Tanex2907/Semester-3-Project/Morphology Chart/List of features V1.png

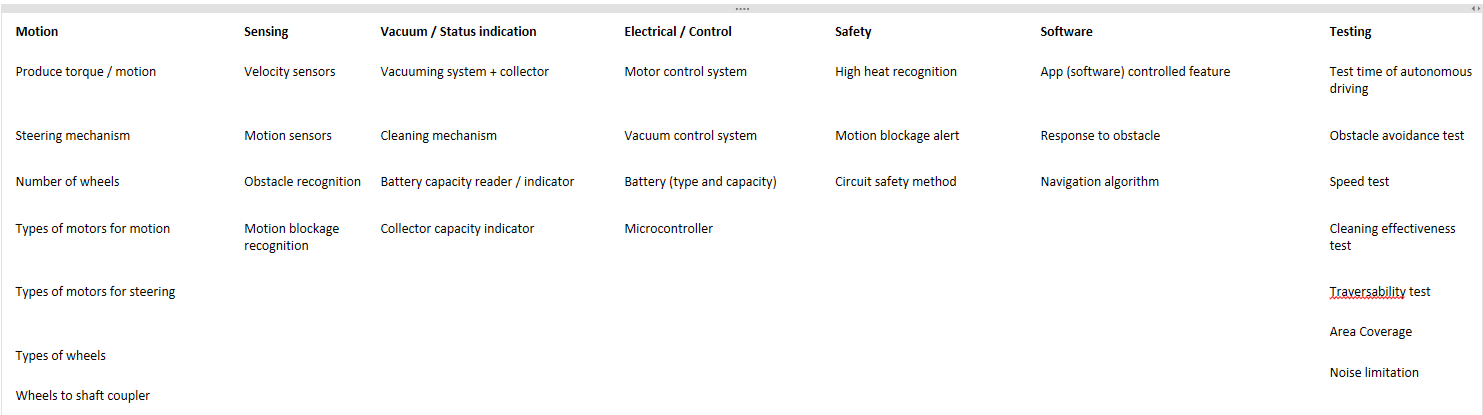
Morphology Chart/List of features V1.png
