Tanex2907/Semester-3-Project/SPRO3MC_E26_component_list_template.xlsx

 |  |  |  | Group Number: |  | 8D
 |  |  |  | Project title: |  | Autonomous Vacuum Robot
 |  |  |  | Name of members: |  | Lukas Pillibeit, Gabriele Gandolfo, Jessica Gomes Tavares, Luis Manso Velasco, Alain Ordonez Ibarra, Francisco Javier Calles Ortega
 |  |  |  | Contact personal: |  | Kun Qian
RS Components |  |  |  |  |  |  |  |  |  | Other Components
Model | Price (DKK) per unit | Link | Part number | Quantity | Pupose (brief in a line) | Total Cost | Statues | Request Date | Order date | Model | Price (DKK) per unit | Link | Part number | Quantity | Pupose (brief in a line) | Total Cost | Statues | Request Date | Order date
MikroElektronika BMI270 | 175.18 | https://dk.rs-online.com/web/p/sensor-udvikling/2494029 | 2494029 | 1 | Used as Gyroscope and Accelermeter | 175.18 | New Order |  |  | Right Mecanum Wheel | 84 | https://let-elektronik.dk/black-mecanum-wheel-with-motor-shaft-coupling-60mm-right | FIT0766 | 1 | Wheels for the Robot | 84 | New Order
Sanyo Denki Blister Centrifugalblæser | 189.64 | https://dk.rs-online.com/web/p/blaesere/1919306 | 1919306 | 1 | The Vacuuming motor | 189.64 | New Order |  |  | Left Mecanum Wheel | 84 | https://let-elektronik.dk/black-mecanum-wheel-with-motor-shaft-coupling-60mm-left | FIT0765 | 1 | Wheels for the Robot | 84 | New Order
Infrarød transceiver | 59.99 | https://dk.rs-online.com/web/p/ir-transceivere/8801999 | 8801999 | 1 | Status sensor for the vacuum chamber | 59.99 | New Order |  |  | Ball Caster | 22.5 | https://let-elektronik.dk/metal-ball-casters | FIT0007 | 1 | Ball Caster as wheel replacement | 22.5 | New Order
Sharp reflektiv optisk sensor | 74.73 | https://dk.rs-online.com/web/p/reflektive-optiske-sensorer/6666568 | 6666568 | 1 | Needed for detecting outer walls | 74.73 | New Order |  |  | VL53L1X ToF Sensor | 75 | https://ardustore.dk/produkt/vl53l1x-laser-tof-afstands-module | 1799 | 1 | Obstacle avoidance sensor | 75 | New Order
Seeit ESP32-DEV-38P | 125.36 | https://dk.rs-online.com/web/p/mikrokontroller-udvikling/2863991 | 2863991 | 1 | Our microcontroller. | 125.36 | New Order |  |  | DC Motor 6V | 15 | https://ardustore.dk/produkt/dc-motor-3v-6v-8000rpm-micro | 1427 | 1 | Brush Motor | 15 | New Order
 |  |  |  |  |  |  | New Order |  |  | Buck Boost Converter | 30 | https://ardustore.dk/produkt/dc-dc-auto-buck-boost-converter-2-5v-15v-to-5v | 3922 | 1 | Step Down Converter | 30 | New Order
 |  |  |  |  |  |  | New Order |  |  | HG16-120-AB-00 Motor | 180.05 | https://dk.farnell.com/en-DK/nidec-components/hg16-120-ab-00/dc-gear-motor-brush-12v-0-12a/dp/4537751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 | 4537751 | 2 | Main Drive Motors | 360.1 | New Order
 |  |  |  |  |  |  |  |  |  | TSC214ICT | 7.83 | https://dk.farnell.com/en-DK/stmicroelectronics/tsc214ict/current-sense-amplifier-40khz/dp/3766517 | 3766517 | 1 | Current Sense Amp | 7.83 | New Order
 |  |  |  |  |  |  |  |  |  | DRI0044 | 28.92 | https://dk.farnell.com/en-DK/dfrobot/dri0044/dc-motor-driver-2-7v-to-5-5v-2ch/dp/3974106 | 3974106 | 1 | Drive Motor Driver | 28.92 | New Order
 |  |  |  |  |  |  | New Order |  |  | SER0043 | 25.71 | https://dk.farnell.com/en-DK/dfrobot/ser0043/servo-motor-micro-0-156n-m-6v/dp/4308285 | 4308285 | 1 | Motor for ToF Sensor | 25.71 | New Order
https://dk.rs-online.com/basket/s/70fce121-66fe-46ff-bb37-7bd21aa1fced
