Tanex2907/Semester-3-Project/(list of files, cad)

Other CAD files:
Components parts/1st shelf.prt
Components parts/Base + Cover/LiDARassembly/ServoLiDARassembly.prt
Components parts/Base + Cover/lidar base.prt
Components parts/Base.prt
Components parts/Centrifugal Blower.prt
Components parts/Electronic components + holders/L298N.prt
Components parts/Electronic components + holders/esp holder.prt
Components parts/Electronic components + holders/optical sensor holder.prt
Components parts/Esp32.prt
Components parts/IMU.prt
Components parts/Infrared Sensor Holder.prt
Components parts/LiDARassembly/Servo.prt
Components parts/LiDARassembly/TOF sensor.prt
Components parts/LiDARattatchment.prt
Components parts/Locking Mechanism.prt
Components parts/Locomotion + motors/Bottom Motor holder.prt
Components parts/MotorWheel coupler.prt
Components parts/Servo.prt
Components parts/Side optical Sensor.prt
Components parts/Stand/1st shelf.prt
Components parts/Stand/battery + pcb stand.prt
Components parts/Stand/screw 3mm.prt
Components parts/TOF sensor.prt
Components parts/Top Motor Holder.prt
Components parts/Vacuum Robot Assembly.prt
Components parts/Vacuum system/Infrared Sensor Case.prt
Components parts/Vacuum system/Infrared Sensor Collector.prt
Components parts/Vacuum system/Locking mechanism cover.prt
Components parts/Vacuum system/Vacuuming System.prt
Components parts/Vacuuming System Case.prt
Components parts/Walls + Bumper/WallBack.prt
Components parts/Walls + Bumper/bumber system wall corner.prt
Components parts/Walls + Bumper/bumber system wall.prt
Components parts/Walls + Bumper/mirror_WallBack.prt
Components parts/Wheel.prt
Components parts/battery holder.prt
Components parts/buck driver.prt
Components parts/bumper.prt
Components parts/caster ball.prt
Components parts/drive motor.prt
Components parts/micro motorprt.prt
Components parts/motor driver.prt
Components parts/optical sensor holder.prt
Components parts/screw.prt
