Tanex2907/Semester-3-Project/Electronics/ESP32 Layout/ESP32.pdf

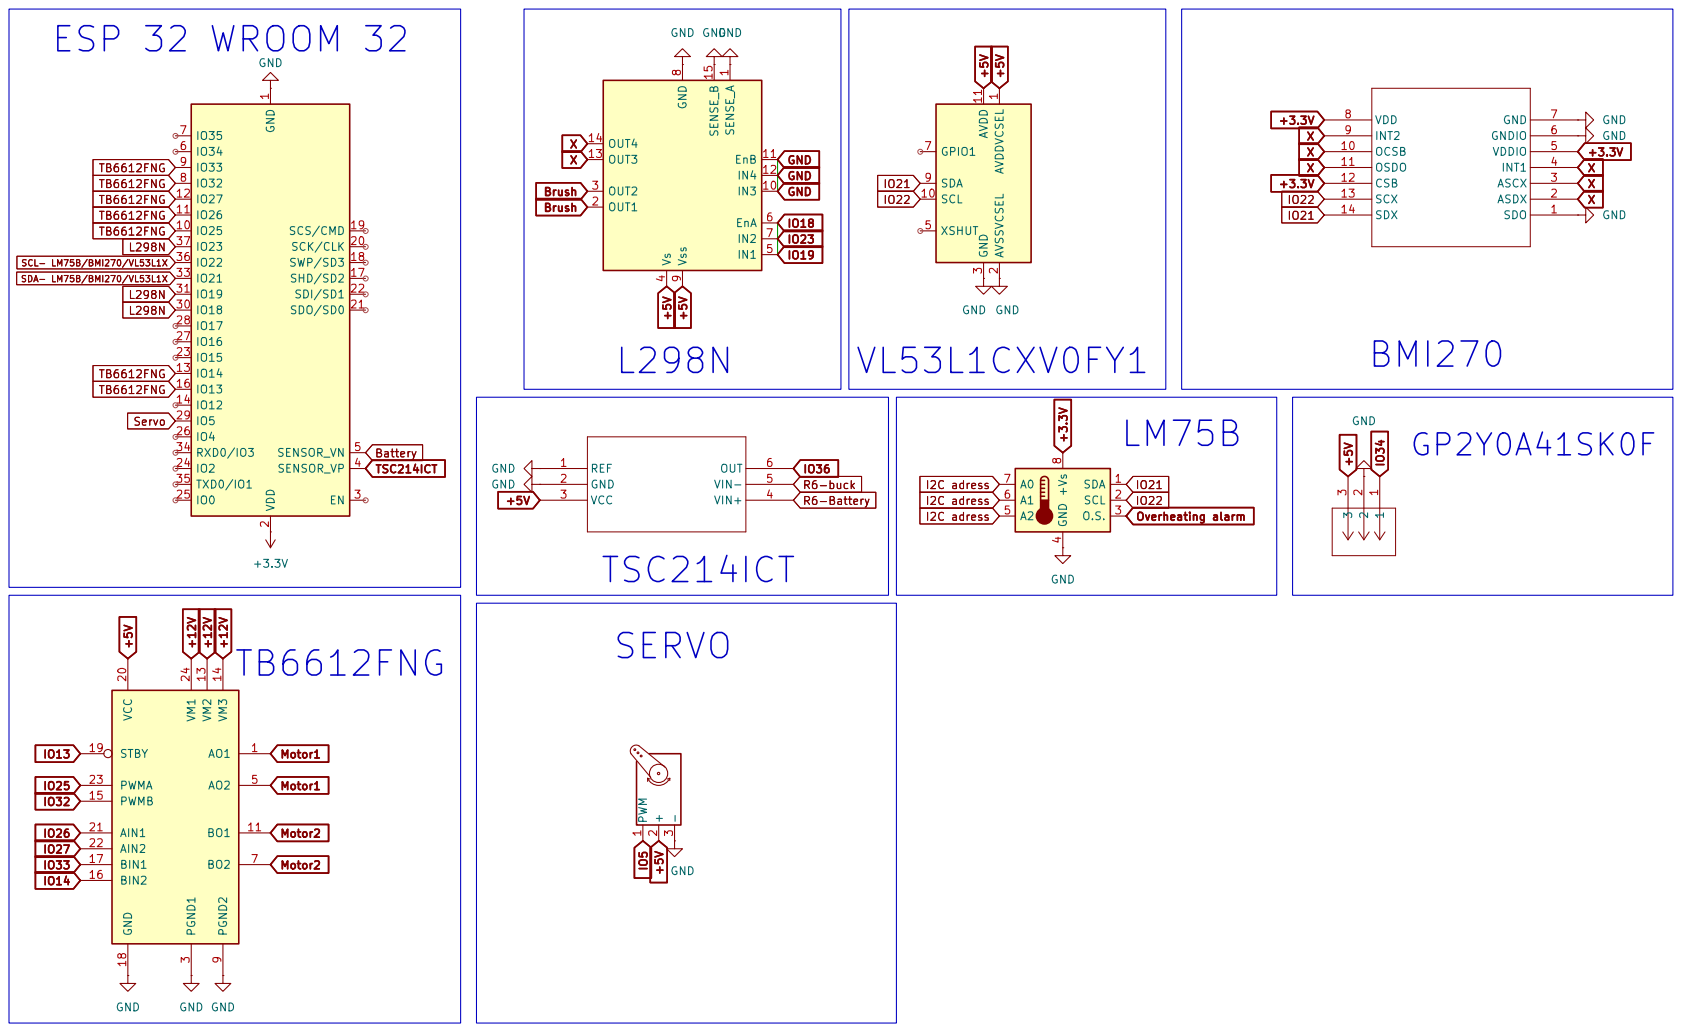
[picture p2: page 1]
