Tanex2907/Semester-3-Project/(list of files, drawings)

Other design files:
Electronics/KicadLibrarySPRO-3/LM317T/Altium/LM317T.SchLib
Electronics/KicadLibrarySPRO-3/LM317T/Altium/TO254P470X1036X1920-3P.PcbLib
