Tanex2907/Semester-3-Project/Electronics/ESP32 Layout/ESP32 layout.kicad_pcb

## KiCad design Electronics/ESP32 Layout/ESP32 layout.kicad_pcb (2026-11-02)

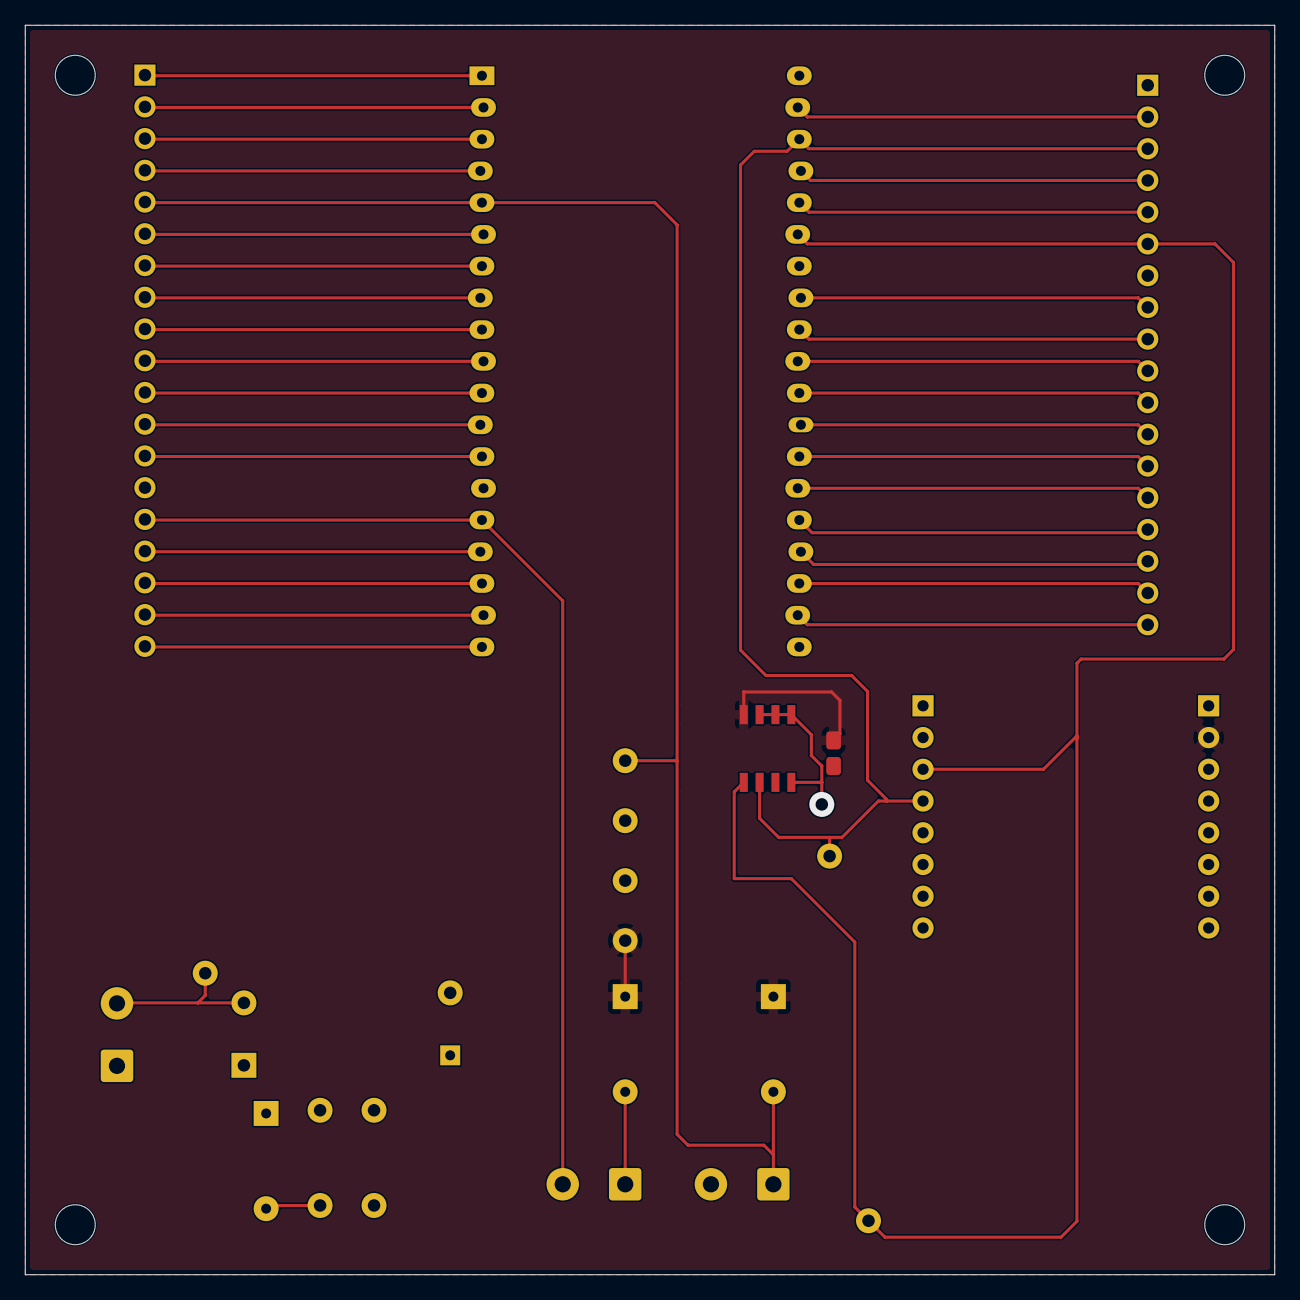
[picture p3: board ESP32 layout.kicad_pcb from above]

Board: 2 copper layers, 100.0 x 100.0 mm, 22 parts (0 on the bottom side), 7 nets.

Parts:
C2, C3: C_Disc_D5.0mm_W2.5mm_P5.00mm
C4: 100nF; C_0805_2012Metric_Pad1.18x1.45mm_HandSolder
H1, H2, H3, H4: MountingHole_3.2mm_M3
IC**: LM75B
J1: IR_LED (OPB100-EZ); TerminalBlock_Phoenix_MKDS-1,5-2_1x02_P5.00mm_Horizontal
J2: IR_SENSOR (OPB100-SZ); TerminalBlock_Phoenix_MKDS-1,5-2_1x02_P5.00mm_Horizontal
R1, R2, R3: R_Axial_DIN0207_L6.3mm_D2.5mm_P7.62mm_Horizontal
R4: 100; R_Axial_DIN0207_L6.3mm_D2.5mm_P7.62mm_Horizontal
R5: 10k; R_Axial_DIN0207_L6.3mm_D2.5mm_P7.62mm_Horizontal
TP1, TP2, TP3, TP4, TP5, TP6, TP7: TestPoint; TestPoint_THTPad_D2.0mm_Drill1.0mm

Connections:
3.3V: C4.2, IC**.8, R4.1, R5.1, TP1.1
5V: C3.2, TP2.1
GND: C2.1, C3.e, C4.1, IC**.4, J2.2, R3.1, TP3.1, TP4.1
I2C_SCL: IC**.2, TP7.1
I2C_SDA: IC**.1, TP6.1
IR_LED_A: J1.1, R4.2
IR_SENSE: J2.1, R5.2, TP5.1
