Tanex2907/Semester-3-Project/Robot/include/Pins.h

#pragma once

#define CURRENT_SENSE       35

#define IR_SENSOR           34

#define MOTOR_DRIVER_1      33
#define MOTOR_DRIVER_2      32
#define MOTOR_DRIVER_3      27
#define MOTOR_DRIVER_4      26
#define MOTOR_DRIVER_5      25

#define L298N_1             23
#define L298N_2             19
#define L298N_3             18

#define TB_DRIVER_1         14
#define TB_DRIVER_2         13

#define SCL                 22
#define SDA                 21

#define UNUSED_1            17
#define UNUSED_2            16
#define UNUSED_3            15
#define UNUSED_4            12
#define UNUSED_5            4

#define SERVO_1             5

#define THERMISTOR_1        36
