Tanex2907/Semester-3-Project/(commit log)

2026-10-07 Addition of Components part file
    [Centrifugal Blower.prt, Esp32.prt, IMU.prt, L298N.prt, Servo.prt, Side optical Sensor.prt, TOF sensor.prt, buck driver.prt]
2026-10-07 Addition of base in components part
    [Base.prt]
2026-10-07 Addition of wheel and coupler
    [MotorWheel coupler.prt, Wheel.prt]
2026-10-07 I am very tired
    [Base.prt, Bottom Motor holder.prt, Top Motor Holder.prt, Vacuum Robot Assembly.prt, drive motor.prt]
2026-10-07 LiDAR assembly
    Contains part files already in the component files, the LiDAR attatchment thingy and an assembly
    [LiDARattatchment.prt, Servo.prt, ServoLiDARassembly.prt, TOF sensor.prt]
2026-10-08 Addition of battery characetistics
2026-10-08 adds Component list
    [SPRO3MC_E26_component_list_template.xlsx]
2026-10-08 adds caster ball model
    [caster ball.prt]
2026-10-08 update assemby
    [Vacuum Robot Assembly.prt]
2026-10-20 First supply schematic
2026-10-23 battery add
2026-10-24 ESP32 Layout
2026-10-26 cad blublublu
2026-10-28 add bumber and lidar base
2026-10-29 addition tof vacuuming system to assembly
2026-11-01 Addition of Collector sensors
2026-11-02 assembly commit
2026-11-02 ESP-32 PCB v1.0
2026-11-02 cad add
2026-11-03 L298N holder plus nozzle on vacuming system
2026-11-03 Current sensor and thermistor
2026-11-04 makes battery indicator dynamic
2026-11-04 Adds popup to stop timer
2026-11-04 PORCO DIO Adds Electronic switch
